imaginaryimpedance/LCR_meter/LCR/LCR.pdf

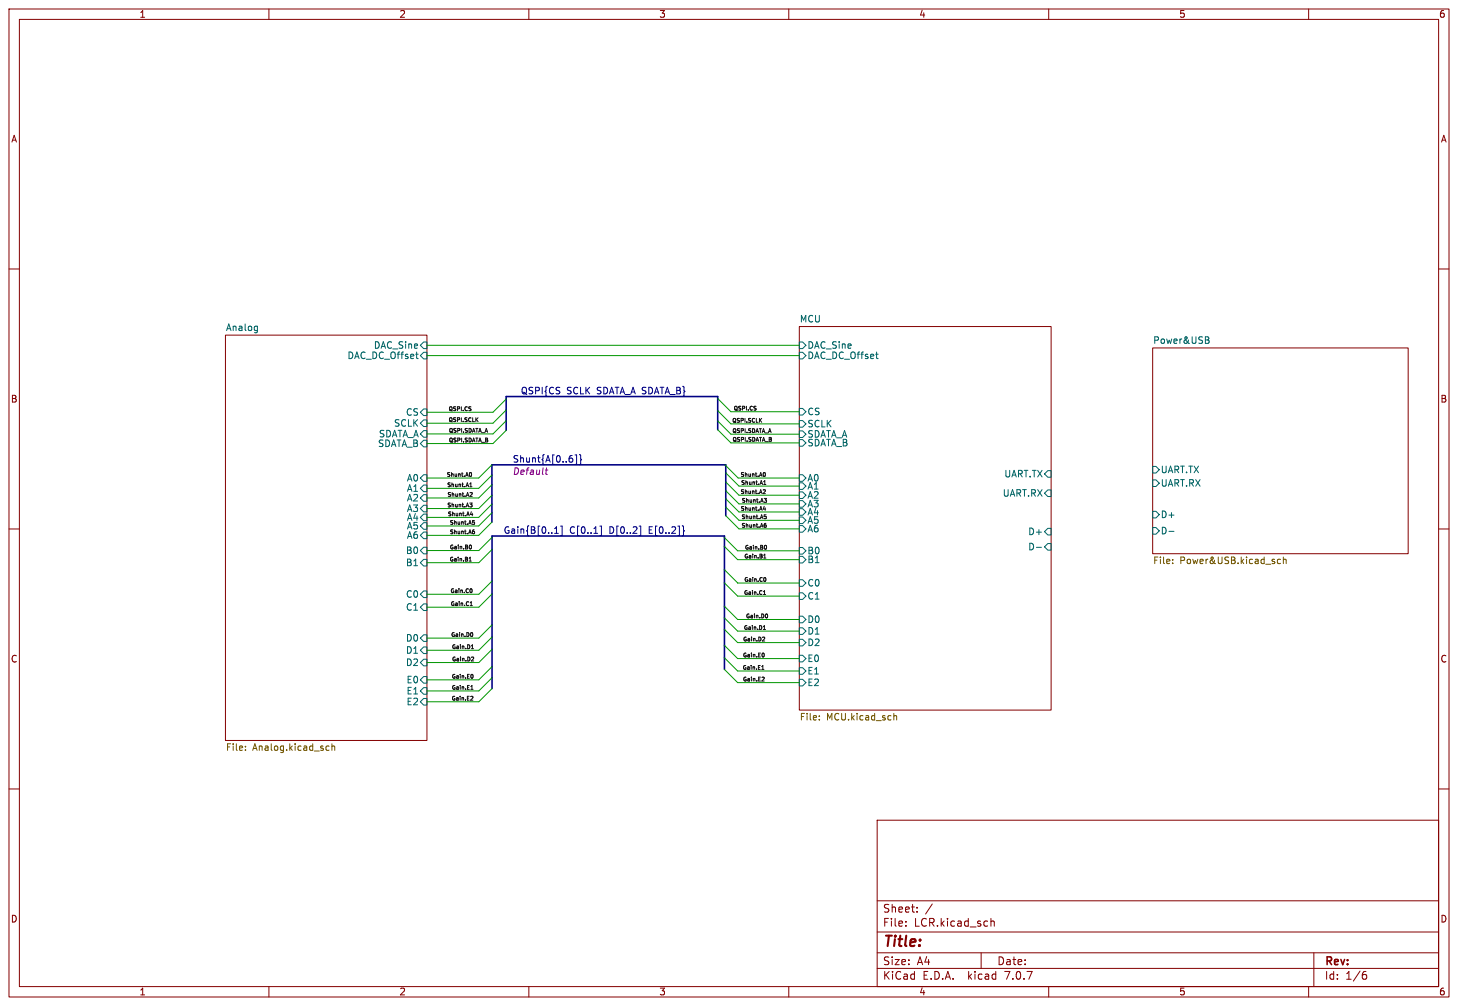
[picture p1: page 1]

Id: 1/6 Title: File: LCR.kicad_sch Sheet: /

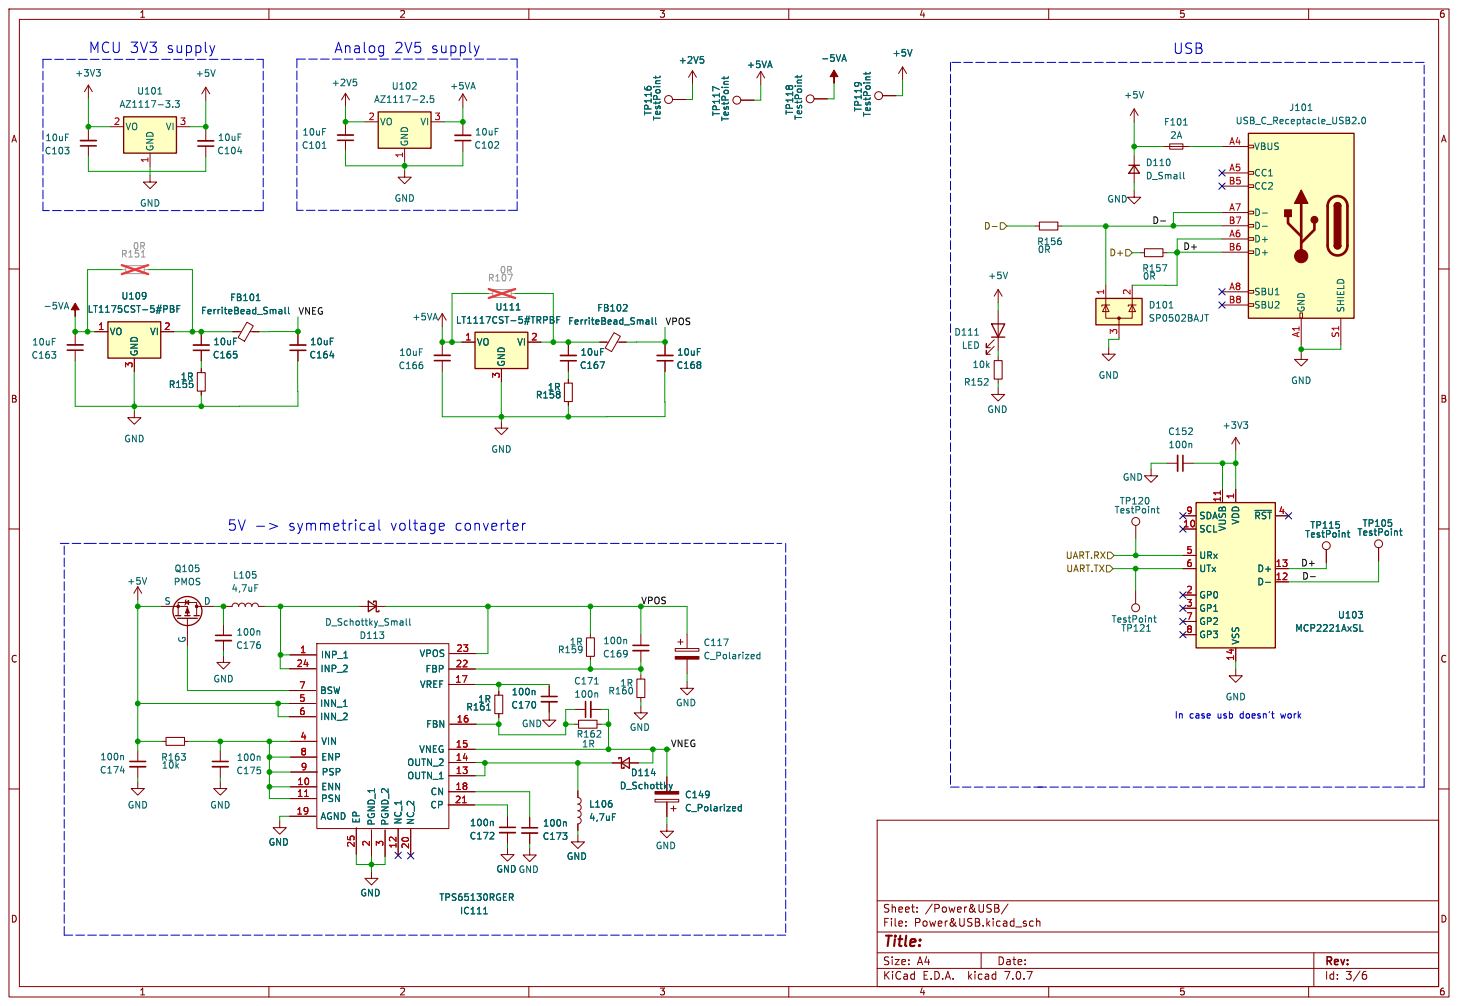
[picture p2: page 2]

In case usb doesn't work USB

1 SCL 10 VUSB 11 D- 12 D+ 13 VSS 14 GP0 2 GP1 3 ~{RST}4 URx 5 UTx 6 GP2 7 GP3 8 SDA 9 U103 MCP2221AxSL TP116 TestPoint

1 SCL 10 VUSB 11 D- 12 D+ 13 VSS 14 GP0 2 GP1 3 ~{RST}4 URx 5 UTx 6 GP2 7 GP3 8 SDA 9 TP115 TestPoint C168

Id: 3/6 Title: File: Power&USB.kicad_sch Sheet: /Power&USB/ GND

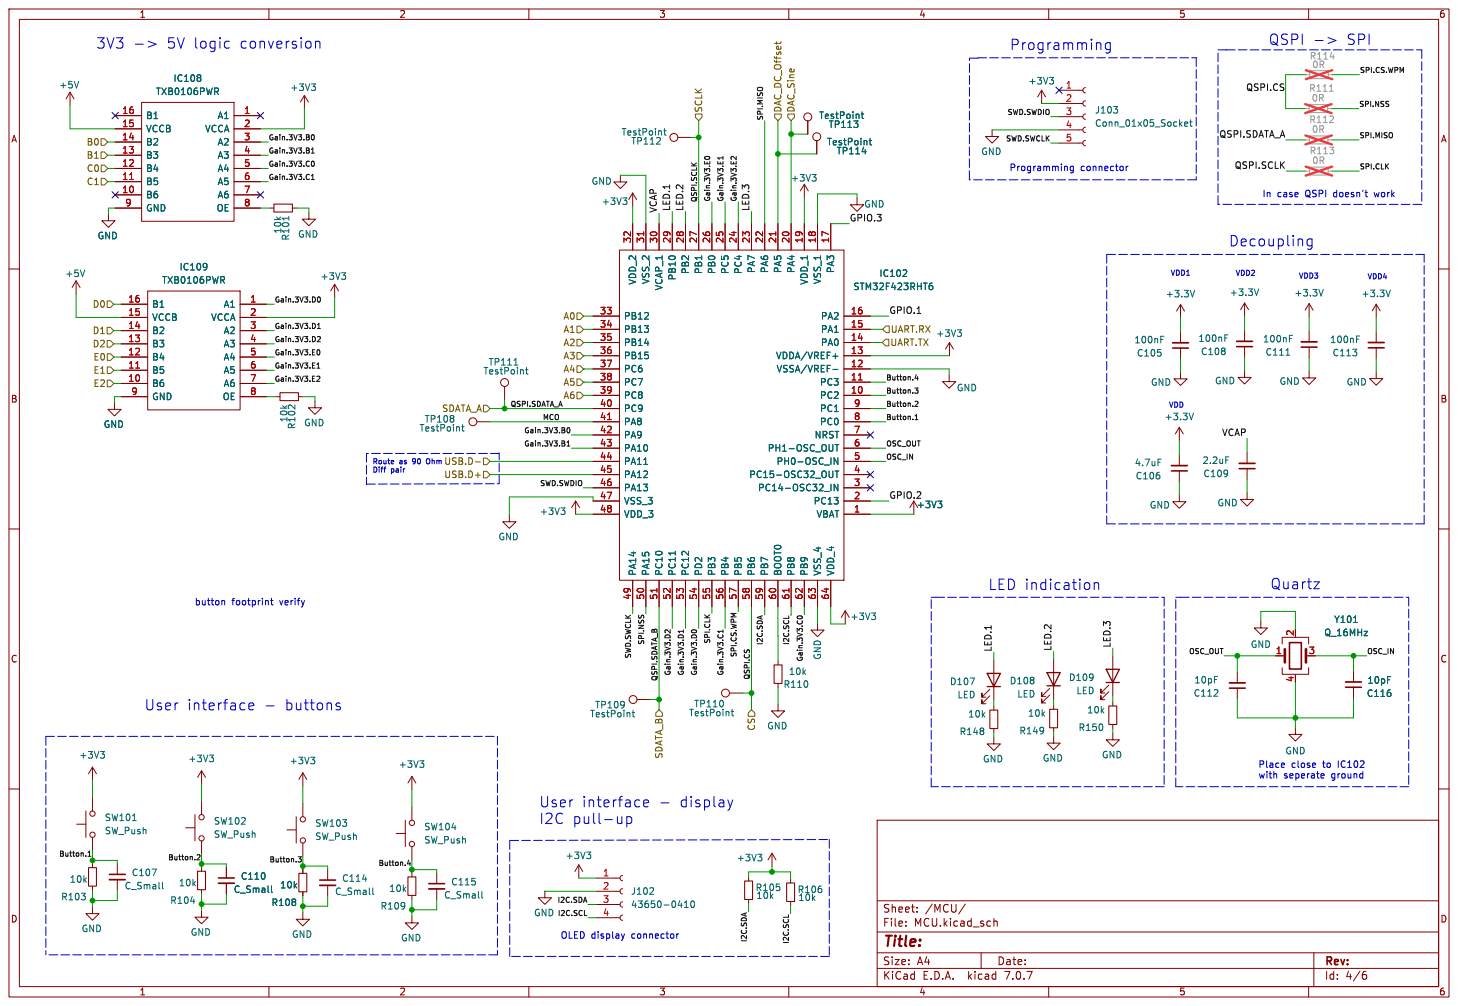
[picture p3: page 3]

In case QSPI doesn't work

Id: 4/6 Title: File: MCU.kicad_sch Sheet: /MCU/ C114 C_Small

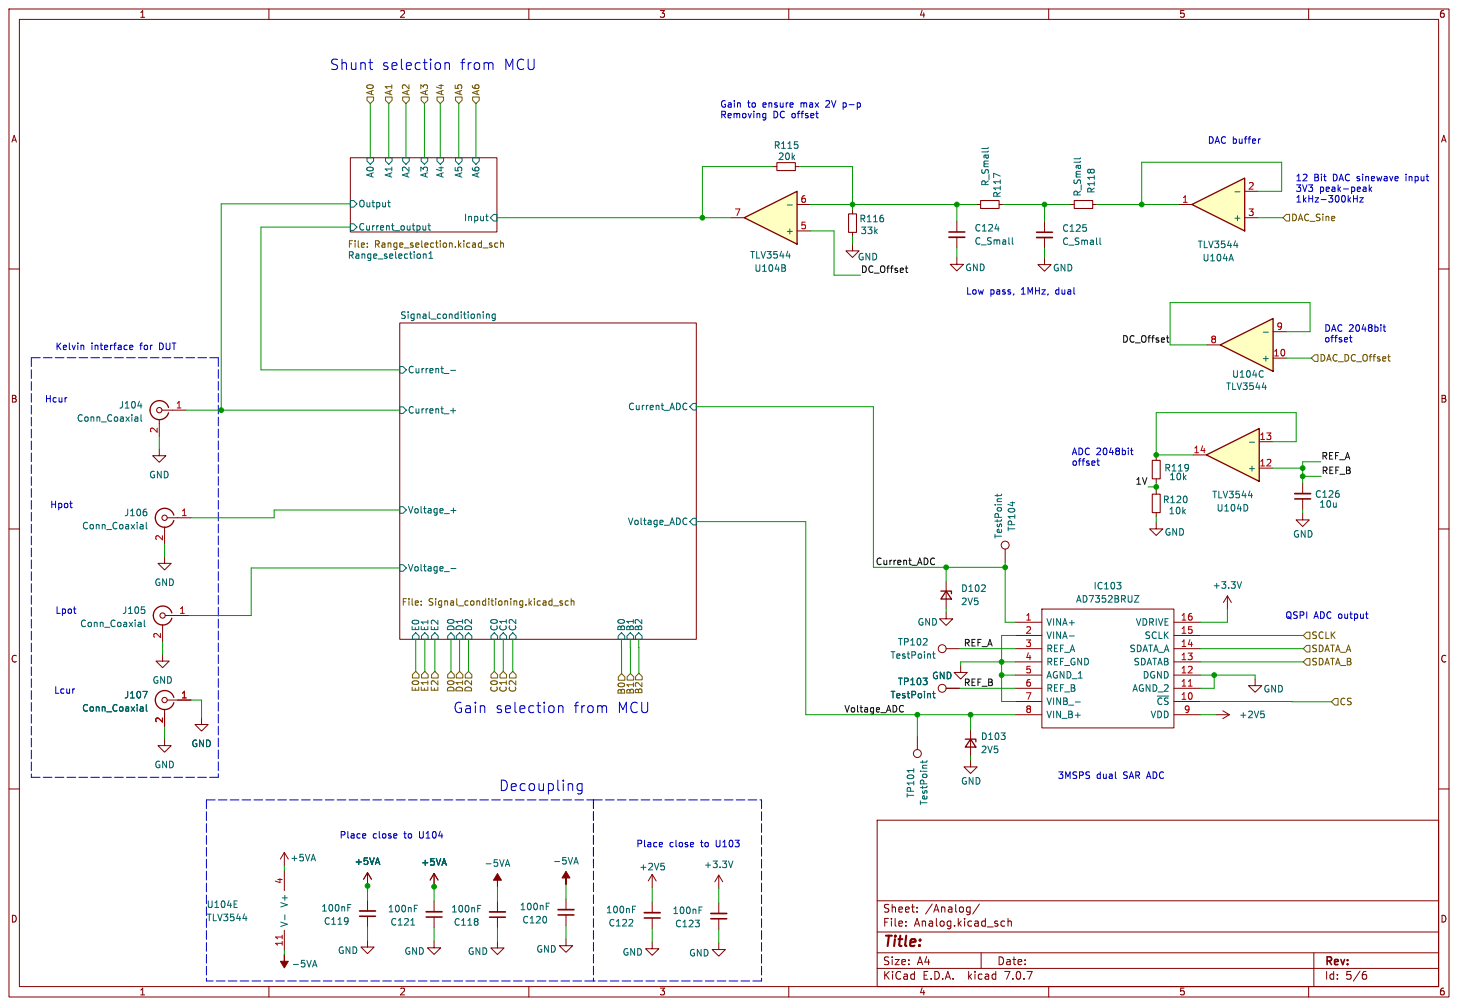
[picture p4: page 4]

Place close to U103 Place close to U104

Id: 5/6 Title: File: Analog.kicad_sch Sheet: /Analog/

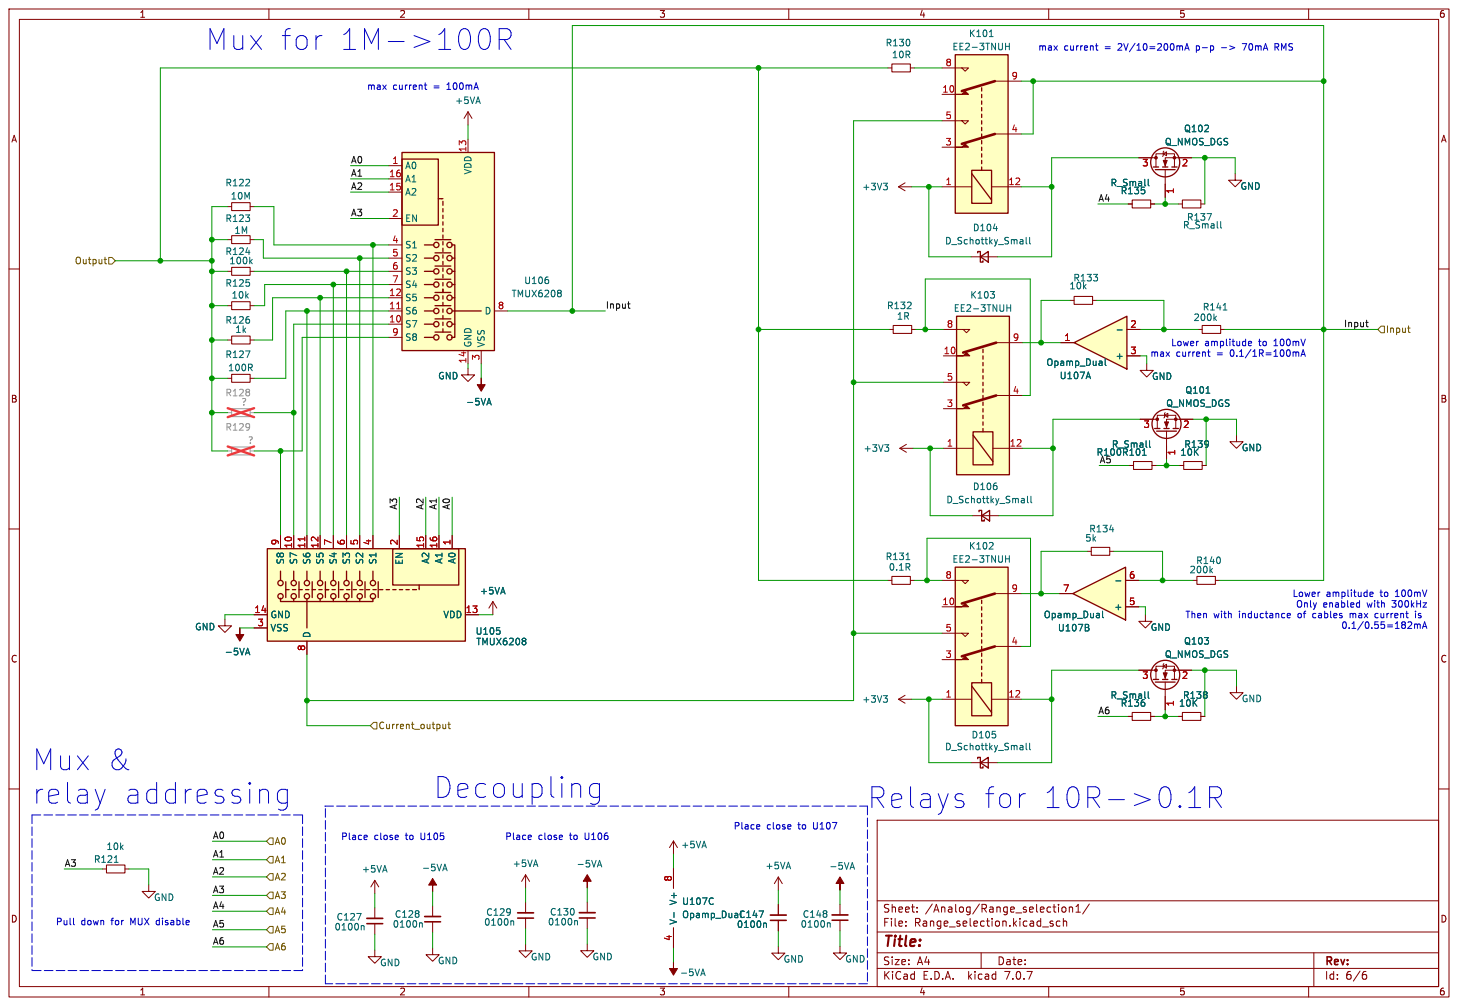
[picture p5: page 5]

Id: 6/6 Title: File: Range_selection.kicad_sch Sheet: /Analog/Range_selection1/

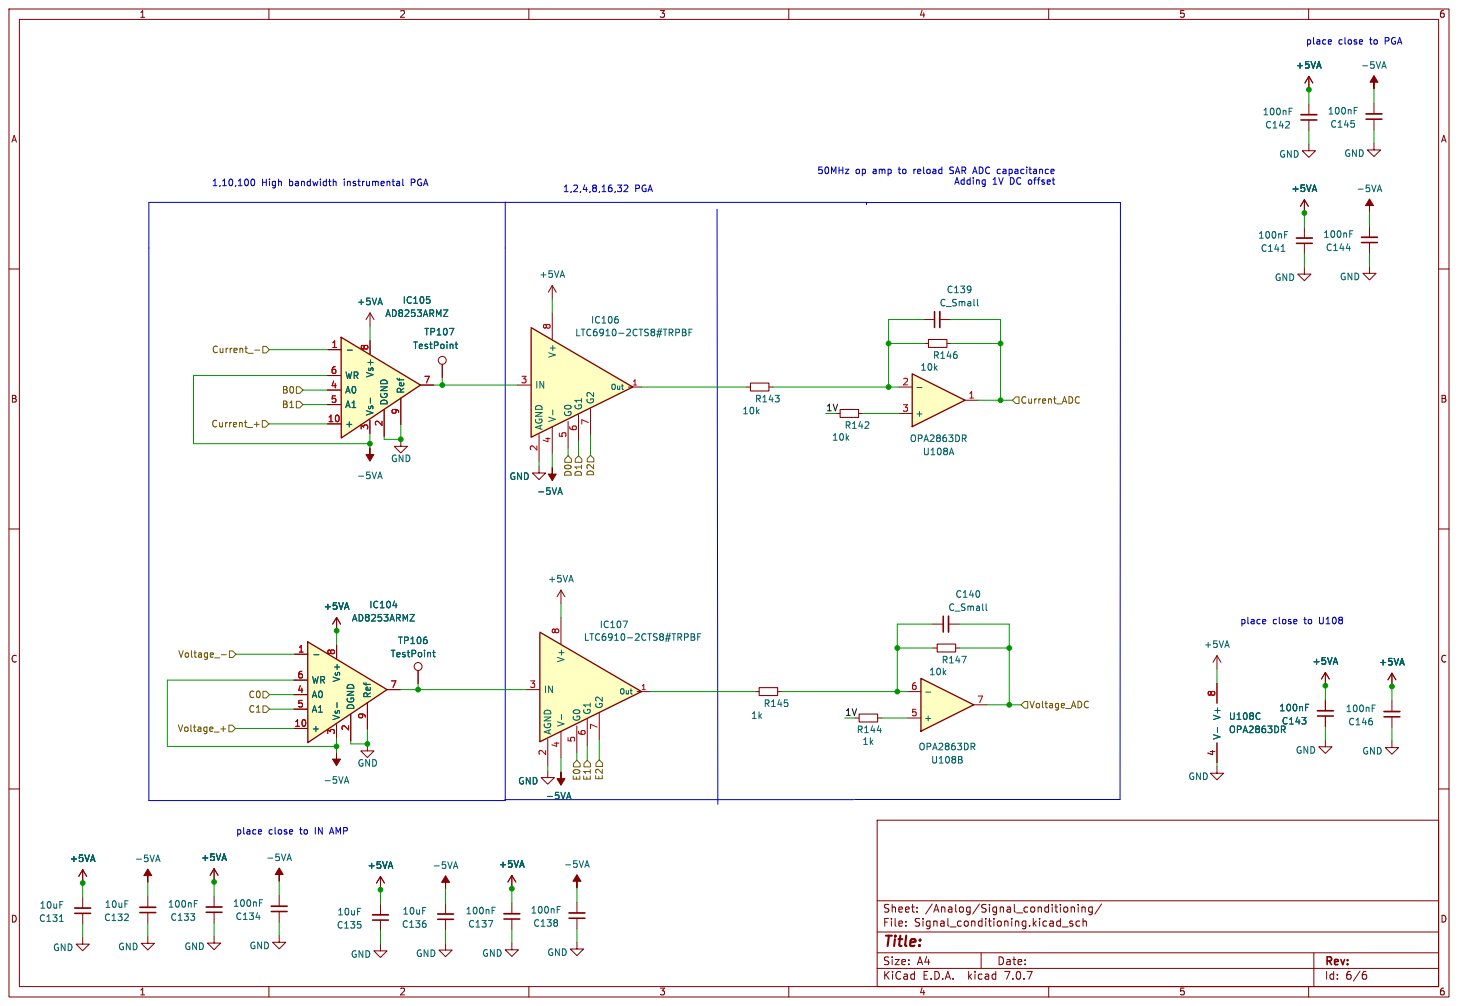
[picture p6: page 6]

place close to PGA

50MHz op amp to reload SAR ADC capacitance

8 Ref 9 IC104 AD8253ARMZ C137
Id: 6/6 Title: File: Signal_conditioning.kicad_sch Sheet: /Analog/Signal_conditioning/ +5VA

place close to IN AMP
