imaginaryimpedance/LCR_meter/LCR/Analog.kicad_sch

## KiCad design LCR/Analog.kicad_sch (2024-11-26)

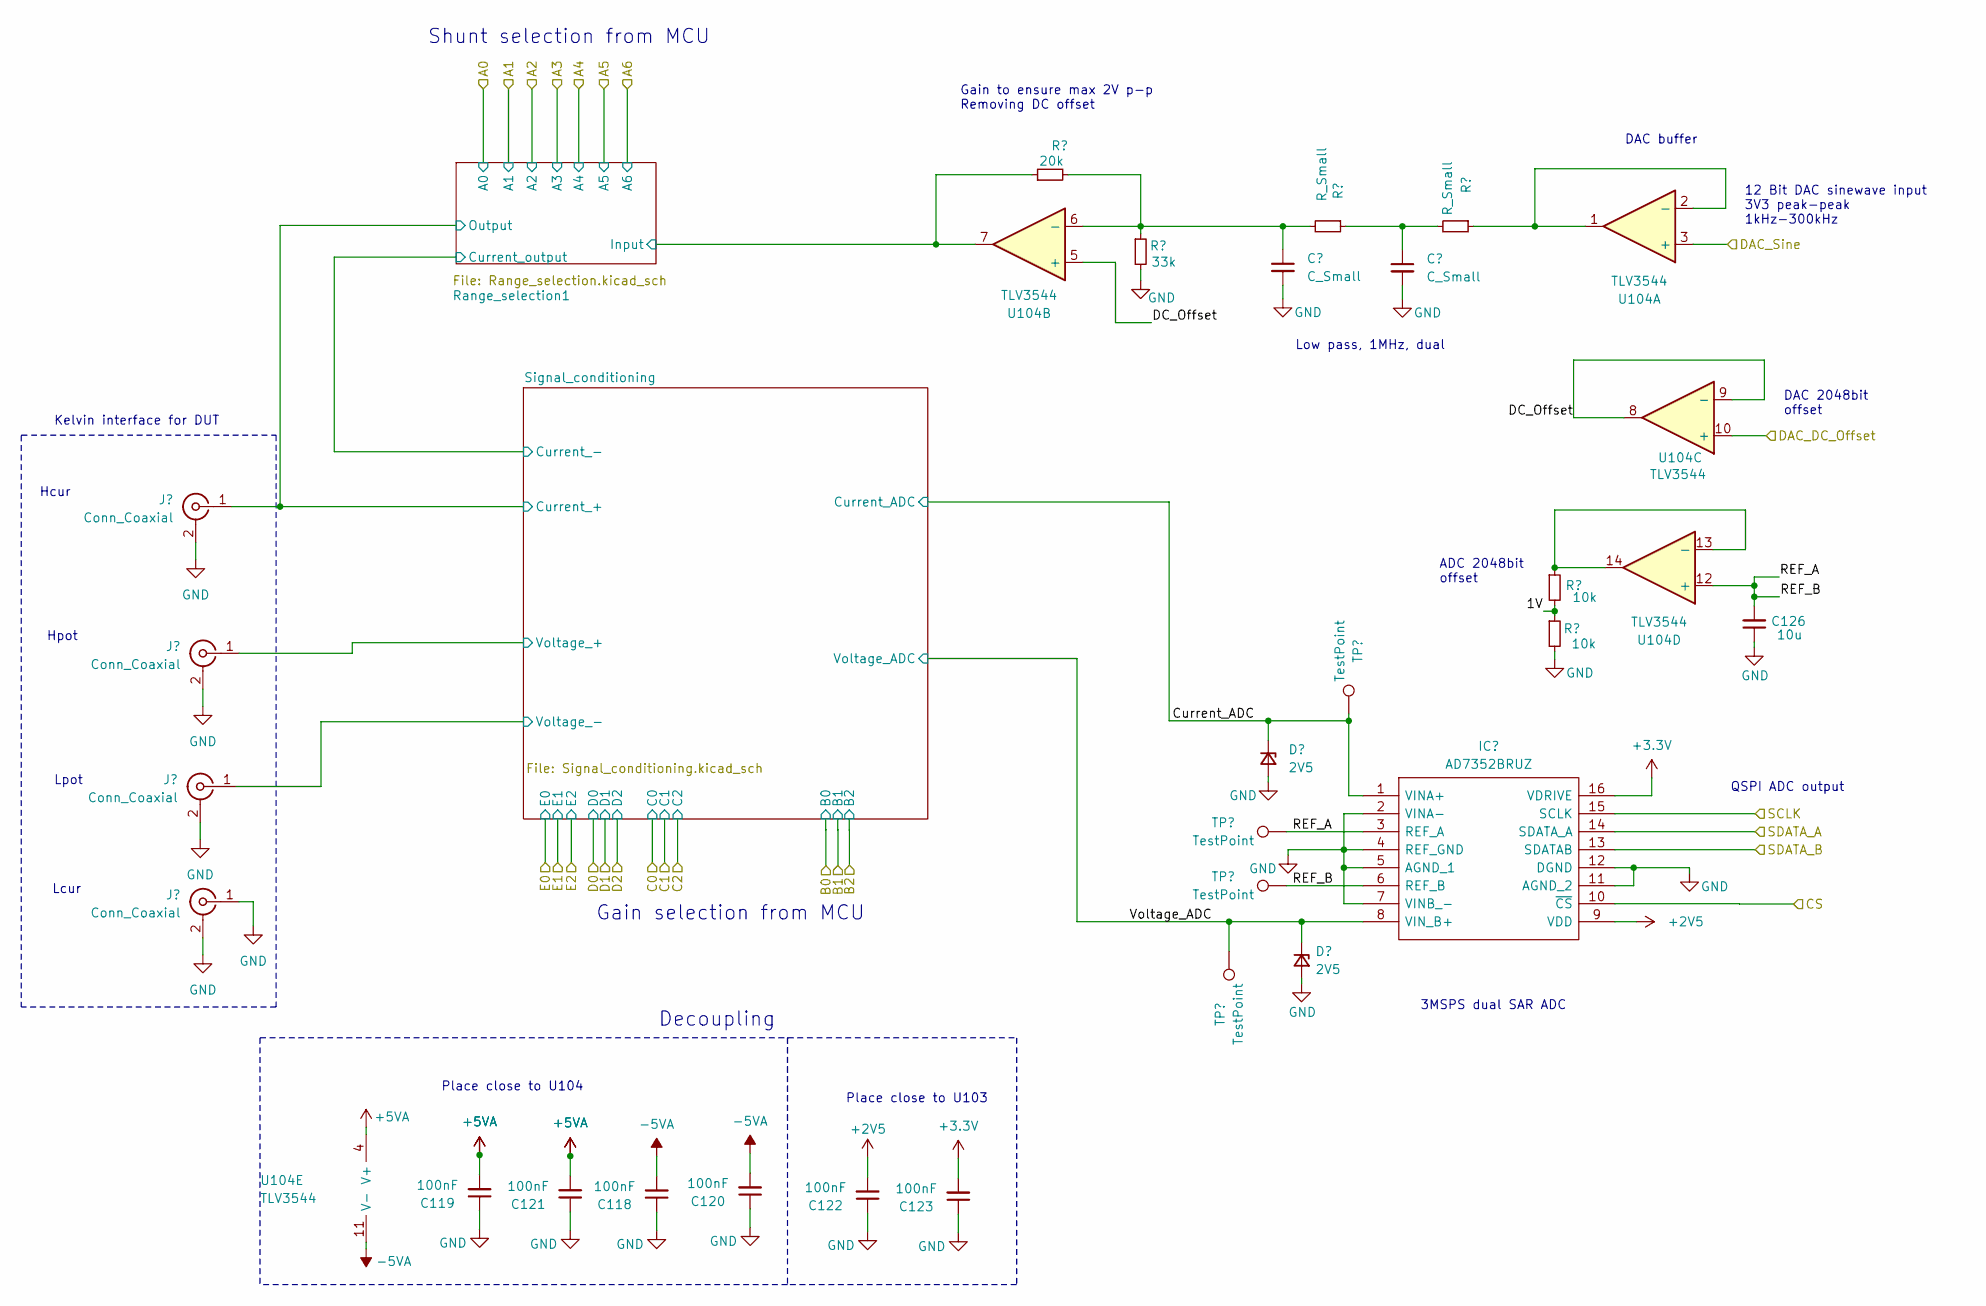
[picture p7: schematic Analog.kicad_sch]

Parts:
C118, C119, C120, C121, C122, C123: 100nF; C_0603_1608Metric
C124, C125: C_Small; C_0603_1608Metric
C126: 10u; C_0603_1608Metric
D102, D103: 2V5; D_SOD-123
IC103: AD7352BRUZ; SOP65P640X120-16N; Manufacturer_Part_Number AD7352BRUZ
J104, J105, J106, J107: Conn_Coaxial; 031543110RFX
R115: 20k; R_0603_1608Metric
R116: 33k; R_0603_1608Metric
R117, R118: R_Small; R_0603_1608Metric
R119, R120: 10k; R_0603_1608Metric
TP101, TP102, TP103, TP104: TestPoint; TestPoint_Pad_D2.0mm
U104: TLV3544; SOIC-14_3.9x8.7mm_P1.27mm

Connections:
1V: R119.2, R120.1
+2V5: C122.2, IC103.9 (VDD)
+3.3V: C123.2, IC103.16 (VDRIVE)
+5VA: C119.2, C121.2, U104.4 (V+)
-5VA: C118.2, C120.2, U104.11 (V-)
CS: IC103.10 (~CS)
Current_+: J104.1 (In)
Current_ADC: D102.1 (K), IC103.1 (VINA+), TP104.1
DAC_DC_Offset: U104.10 (+)
DAC_Sine: U104.3 (+)
DC_Offset: U104.5 (+), U104.8, U104.9 (-)
GND: C118.1, C119.1, C120.1, C121.1, C122.1, C123.1, C124.2, C125.2, C126.1, D102.2 (A), D103.2 (A), IC103.2 (VINA-), IC103.4 (REF_GND), IC103.5 (AGND_1), IC103.7 (VINB_-), IC103.11 (AGND_2), IC103.12 (DGND), J104.2 (Ext), J105.2 (Ext), J106.2 (Ext), J107.1 (In), J107.2 (Ext), R116.2, R120.2
Input: R115.1, U104.7
unnamed: C124.1, R115.2, R116.1, R117.2, U104.6 (-)
unnamed: C125.1, R117.1, R118.2
unnamed: R118.1, U104.1, U104.2 (-)
unnamed: R119.1, U104.13 (-), U104.14
REF_A: C126.2, IC103.3 (REF_A), IC103.6 (REF_B), TP102.1, TP103.1, U104.12 (+)
SCLK: IC103.15 (SCLK)
SDATA_A: IC103.14 (SDATA_A)
SDATA_B: IC103.13 (SDATAB)
Voltage_+: J106.1 (In)
Voltage_-: J105.1 (In)
Voltage_ADC: D103.1 (K), IC103.8 (VIN_B+), TP101.1

Notes on the sheet:
Gain selection from MCU
Shunt selection from MCU
QSPI ADC output
Lcur
Decoupling
Place close to U103
ADC 2048bit offset
DAC 2048bit offset
3MSPS dual SAR ADC
Place close to U104
12 Bit DAC sinewave input 3V3 peak-peak 1kHz-300kHz
Low pass, 1MHz, dual
Lpot
Hcur
Kelvin interface for DUT
Hpot
DAC buffer
Gain to ensure max 2V p-p Removing DC offset
