imaginaryimpedance/LCR_meter/LCR/MCU.kicad_sch

## KiCad design LCR/MCU.kicad_sch (2024-11-26)

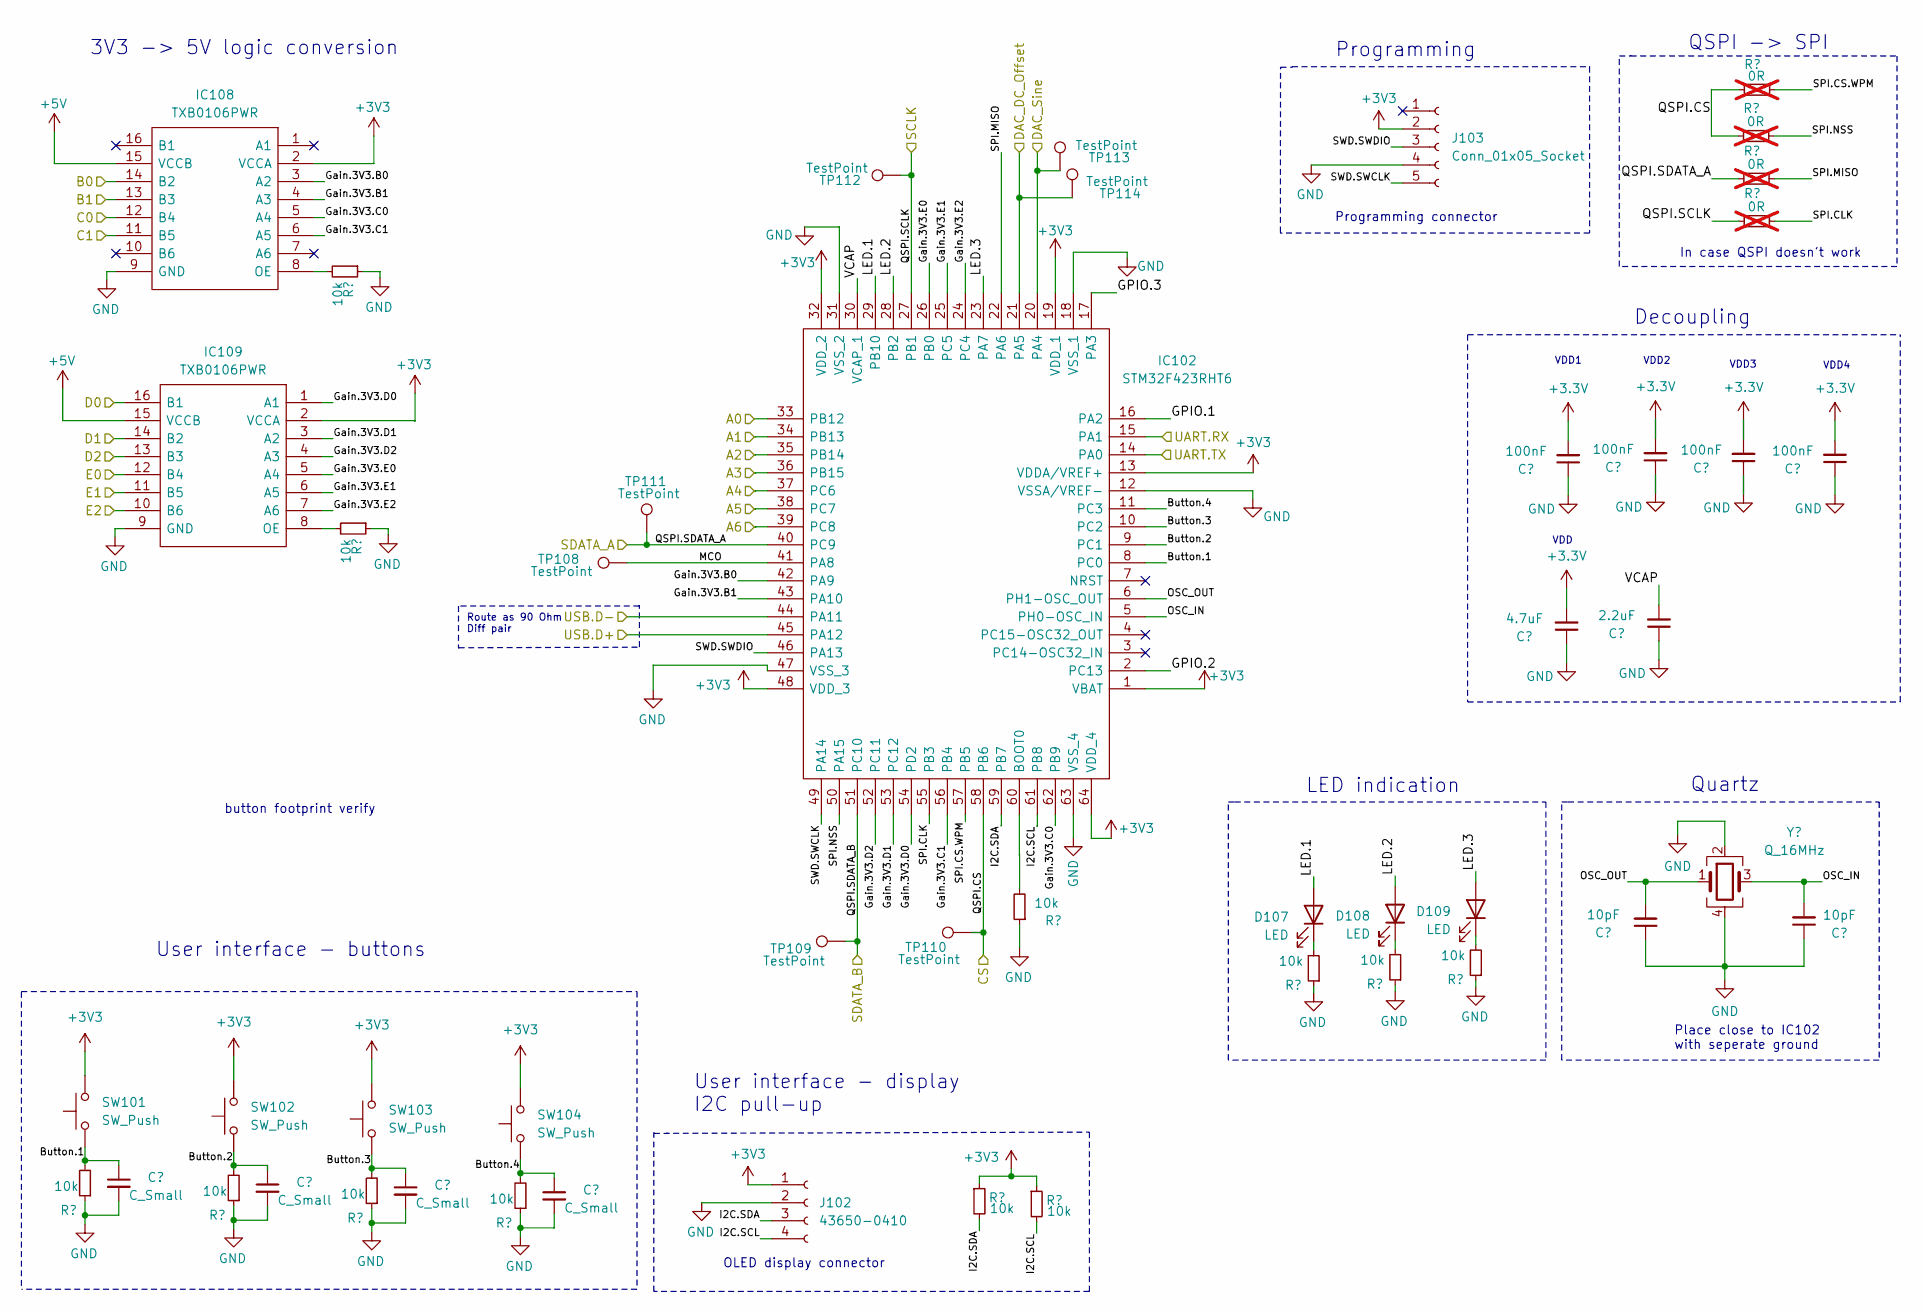
[picture p8: schematic MCU.kicad_sch]

Parts:
C105, C108, C111, C113: 100nF; C_0603_1608Metric
C106: 4.7uF; C_0603_1608Metric
C107, C110, C114, C115: C_Small; C_0603_1608Metric
C109: 2.2uF; C_0603_1608Metric
C112, C116: 10pF; C_0603_1608Metric
D107, D108, D109: LED; LED_1206_3216Metric
IC102: STM32F423RHT6; QFP50P1200X1200X160-64N; Manufacturer_Part_Number STM32F423RHT6; Mouser Part Number 511-STM32F423RHT6
IC108, IC109: TXB0106PWR; SOP65P640X120-16N; Manufacturer_Part_Number TXB0106PWR; Mouser Part Number 595-TXB0106PWR
J102: 43650-0410; 43650-04YY_091011
J103: Conn_01x05_Socket; PinHeader_1x04_P2.54mm_Vertical
R101, R102, R103, R104, R105, R106, R108, R109, R110, R148, R149, R150: 10k; R_0603_1608Metric
R111, R112, R113, R114: 0R; R_0603_1608Metric; not fitted
SW101, SW102, SW103, SW104: SW_Push; SW_Push_1P1T_NO_CK_KSC7xxJ
TP108, TP109, TP110, TP111, TP112, TP113, TP114: TestPoint; TestPoint_Pad_D2.0mm
Y101: Q_16MHz; FH4800014

Connections:
+3.3V: C105.2, C106.2, C108.2, C111.2, C113.2
+3V3: IC102.1 (VBAT), IC102.13 (VDDA/VREF+), IC102.19 (VDD_1), IC102.32 (VDD_2), IC102.48 (VDD_3), IC102.64 (VDD_4), IC108.2 (VCCA), IC109.2 (VCCA), J102.1, J103.2, R105.1, R106.1, SW101.2, SW102.2, SW103.2, SW104.2
+5V: IC108.15 (VCCB), IC109.15 (VCCB)
A0: IC102.33 (PB12)
A1: IC102.34 (PB13)
A2: IC102.35 (PB14)
A3: IC102.36 (PB15)
A4: IC102.37 (PC6)
A5: IC102.38 (PC7)
A6: IC102.39 (PC8)
B0: IC108.14 (B2)
B1: IC108.13 (B3)
Button.1: C107.1, IC102.8 (PC0), R103.2, SW101.1
Button.2: C110.1, IC102.9 (PC1), R104.2, SW102.1
Button.3: C114.1, IC102.10 (PC2), R108.2, SW103.1
Button.4: C115.1, IC102.11 (PC3), R109.2, SW104.1
C0: IC108.12 (B4)
C1: IC108.11 (B5)
CS: IC102.58 (PB6), R111.2, R114.2, TP110.1
D0: IC109.16 (B1)
D1: IC109.14 (B2)
D2: IC109.13 (B3)
DAC_DC_Offset: IC102.21 (PA5), TP114.1
DAC_Sine: IC102.20 (PA4), TP113.1
E0: IC109.12 (B4)
E1: IC109.11 (B5)
E2: IC109.10 (B6)
GND: C105.1, C106.1, C107.2, C108.1, C109.1, C110.2, C111.1, C112.1, C113.1, C114.2, C115.2, C116.1, IC102.12 (VSSA/VREF-), IC102.18 (VSS_1), IC102.31 (VSS_2), IC102.47 (VSS_3), IC102.63 (VSS_4), IC108.9 (GND), IC109.9 (GND), J102.2, J103.4, R101.1, R102.1, R103.1, R104.1, R108.1, R109.1, R110.1, R148.1, R149.1, R150.1, Y101.2, Y101.4
GPIO.1: IC102.16 (PA2)
GPIO.2: IC102.2 (PC13)
GPIO.3: IC102.17 (PA3)
Gain.3V3.B0: IC102.42 (PA9), IC108.3 (A2)
Gain.3V3.B1: IC102.43 (PA10), IC108.4 (A3)
Gain.3V3.C0: IC102.62 (PB9), IC108.5 (A4)
Gain.3V3.C1: IC102.56 (PB4), IC108.6 (A5)
Gain.3V3.D0: IC102.54 (PD2), IC109.1 (A1)
Gain.3V3.D1: IC102.53 (PC12), IC109.3 (A2)
Gain.3V3.D2: IC102.52 (PC11), IC109.4 (A3)
Gain.3V3.E0: IC102.26 (PB0), IC109.5 (A4)
Gain.3V3.E1: IC102.25 (PC5), IC109.6 (A5)
Gain.3V3.E2: IC102.24 (PC4), IC109.7 (A6)
I2C.SCL: IC102.61 (PB8), J102.4, R106.2
I2C.SDA: IC102.59 (PB7), J102.3, R105.2
LED.1: D107.2 (A), IC102.29 (PB10)
LED.2: D108.2 (A), IC102.28 (PB2)
LED.3: D109.2 (A), IC102.23 (PA7)
MCO: IC102.41 (PA8), TP108.1
unnamed: D107.1 (K), R148.2
unnamed: D108.1 (K), R149.2
unnamed: D109.1 (K), R150.2
unnamed: IC102.60 (BOOT0), R110.2
unnamed: IC108.8 (OE), R101.2
unnamed: IC109.8 (OE), R102.2
OSC_IN: C116.2, IC102.5 (PH0-OSC_IN), Y101.3
OSC_OUT: C112.2, IC102.6 (PH1-OSC_OUT), Y101.1
QSPI.SCLK: IC102.27 (PB1), R113.2, TP112.1
QSPI.SDATA_A: IC102.40 (PC9), R112.2, TP111.1
QSPI.SDATA_B: IC102.51 (PC10), TP109.1
SPI.CLK: IC102.55 (PB3), R113.1
SPI.CS.WPM: IC102.57 (PB5), R114.1
SPI.MISO: IC102.22 (PA6), R112.1
SPI.NSS: IC102.50 (PA15), R111.1
SWD.SWCLK: IC102.49 (PA14), J103.5
SWD.SWDIO: IC102.46 (PA13), J103.3
UART.RX: IC102.15 (PA1)
UART.TX: IC102.14 (PA0)
USB.D+: IC102.45 (PA12)
USB.D-: IC102.44 (PA11)
VCAP: C109.2, IC102.30 (VCAP_1)

Notes on the sheet:
3V3 -> 5V logic conversion
VDD
VDD1
Route as 90 Ohm Diff pair
QSPI -> SPI
Quartz
In case QSPI doesn't work
VDD3
VDD4
User interface - display I2C pull-up
button footprint verify
User interface - buttons
LED indication
VDD2
Place close to IC102 with seperate ground
Programming connector
Programming
OLED display connector
Decoupling
