imaginaryimpedance/LCR_meter/LCR/Power&USB.kicad_sch

## KiCad design LCR/Power&USB.kicad_sch (2024-11-26)

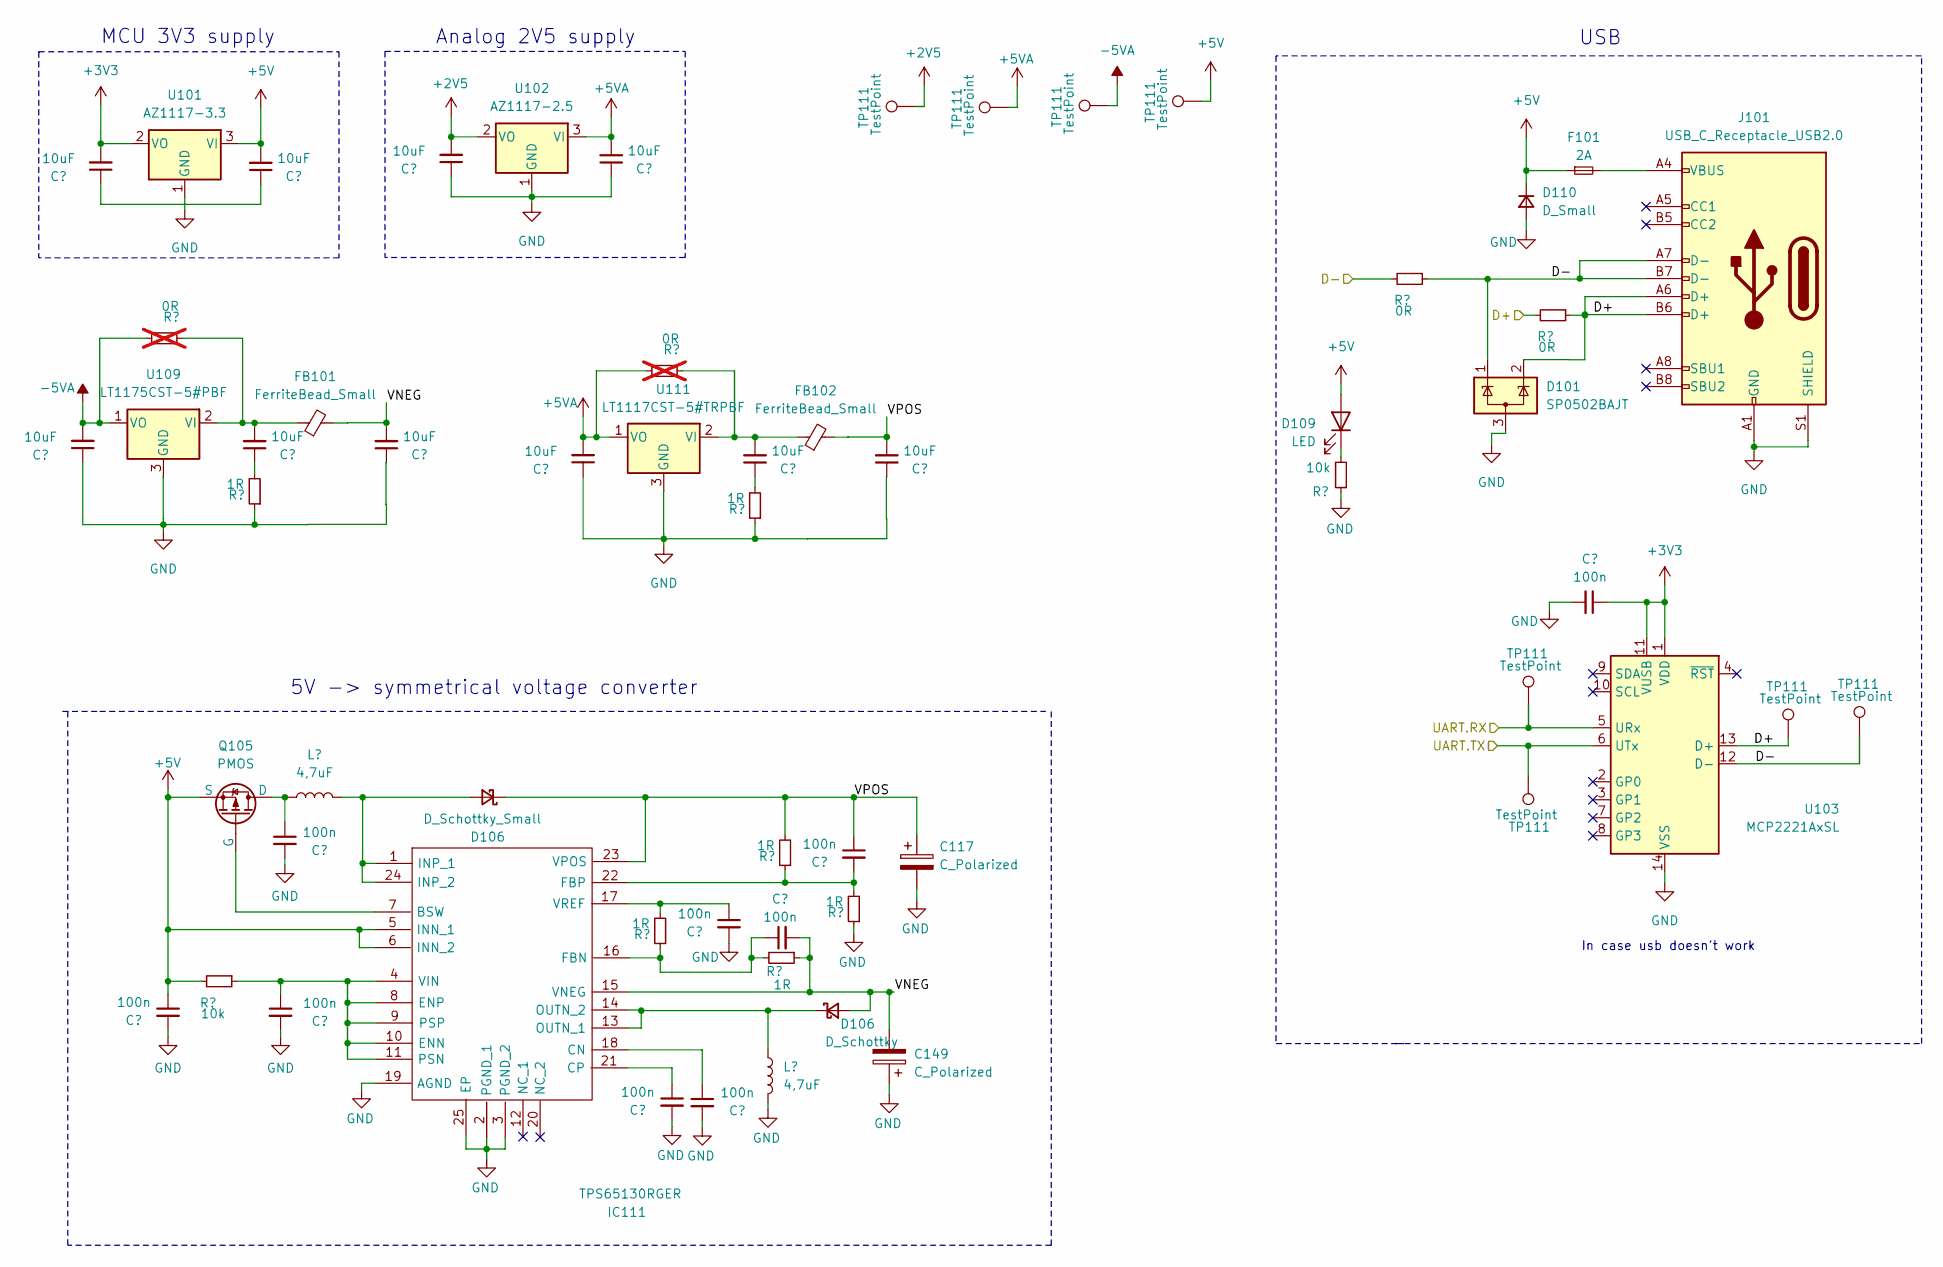
[picture p9: schematic Power&USB.kicad_sch]

Parts:
C105: 100n; C_0603_1608Metric
C117, C149: C_Polarized; CP_Elec_5x5.3
D101: SP0502BAJT; SOT-23-3
D106: D_Schottky; D_SOD-123
D109: LED; LED_1206_3216Metric
D110: D_Small; D_SOD-123
F101: 2A; R_1206_3216Metric
FB101, FB102: FerriteBead_Small; R_1206_3216Metric
IC111: TPS65130RGER; QFN50P400X400X100-25N-D; Manufacturer_Part_Number TPS65130RGER; Mouser Part Number 595-TPS65130RGER
J101: USB_C_Receptacle_USB2.0; USB_C_Receptacle_GCT_USB4115-03-C
L105, L106: 4,7uF; 744031004
Q105: PMOS; SOT-23-3
R105: 0R; R_0603_1608Metric; not fitted
R150: 10k; R_0603_1608Metric
TP111: TestPoint; TestPoint_Pad_D2.0mm
U101: AZ1117-3.3; SOT-89-3
U102: AZ1117-2.5; SOT-89-3
U103: MCP2221AxSL; SOIC-14_3.9x8.7mm_P1.27mm
U109: LT1175CST-5#PBF; SOT-223-3_TabPin2
U111: LT1117CST-5#TRPBF; SOT-223-3_TabPin2

Connections:
+2V5: C105.2, TP111.1, U102.2 (VO)
+3V3: C105.1, C105.2, U101.2 (VO), U103.1 (VDD), U103.11 (VUSB)
+5V: C105.1, C105.2, D109.2 (A), D110.1 (K), F101.1, IC111.5 (INN_1), IC111.6 (INN_2), Q105.2 (S), R105.2, TP111.1, U101.3 (VI)
+5VA: C105.2, R105.1, TP111.1, U102.3 (VI), U111.1 (VO)
-5VA: C105.2, R105.1, TP111.1, U109.1 (VO)
D+: D101.2 (K), J101.A6 (D+), J101.B6 (D+), R105.1, R105.2, TP111.1, U103.13 (D+)
D-: D101.1 (K), J101.A7 (D-), J101.B7 (D-), R105.1, R105.2, TP111.1, U103.12 (D-)
GND: C105.1, C105.2, C117.2, C149.1, D101.3 (A), D110.2 (A), IC111.2 (PGND_1), IC111.3 (PGND_2), IC111.19 (AGND), IC111.25 (EP), J101.A1 (GND), J101.A12 (GND), J101.B1 (GND), J101.B12 (GND), J101.S1 (SHIELD), L106.2, R105.1, R150.1, U101.1 (GND), U102.1 (GND), U103.14 (VSS), U109.3 (GND), U111.3 (GND)
unnamed: C105.1, IC111.4 (VIN), IC111.8 (ENP), IC111.9 (PSP), IC111.10 (ENN), IC111.11 (PSN), IC111.16 (FBN), IC111.17 (VREF), IC111.18 (CN), IC111.21 (CP), L105.1, Q105.3 (D), R105.1, R105.2
unnamed: C105.2, FB101.1, FB102.1, IC111.22 (FBP), R105.1, R105.2, U109.2 (VI), U111.2 (VI)
unnamed: D106.1 (K), IC111.13 (OUTN_1), IC111.14 (OUTN_2), L106.1
unnamed: D106.2 (A), IC111.1 (INP_1), IC111.24 (INP_2), L105.2
unnamed: D109.1 (K), R150.2
unnamed: F101.2, J101.A4 (VBUS), J101.A9 (VBUS), J101.B4 (VBUS), J101.B9 (VBUS)
unnamed: IC111.7 (BSW), Q105.1 (G)
UART.RX: TP111.1, U103.5 (URx)
UART.TX: TP111.1, U103.6 (UTx)
VNEG: C105.2, C149.2, D106.2 (A), FB101.2, IC111.15 (VNEG), R105.1
VPOS: C105.1, C105.2, C117.1, D106.1 (K), FB102.2, IC111.23 (VPOS), R105.2

Notes on the sheet:
In case usb doesn't work
USB
MCU 3V3 supply
5V -> symmetrical voltage converter
Analog 2V5 supply
