imaginaryimpedance/LCR_meter/LCR/Range_selection.kicad_sch

## KiCad design LCR/Range_selection.kicad_sch (2024-11-26)

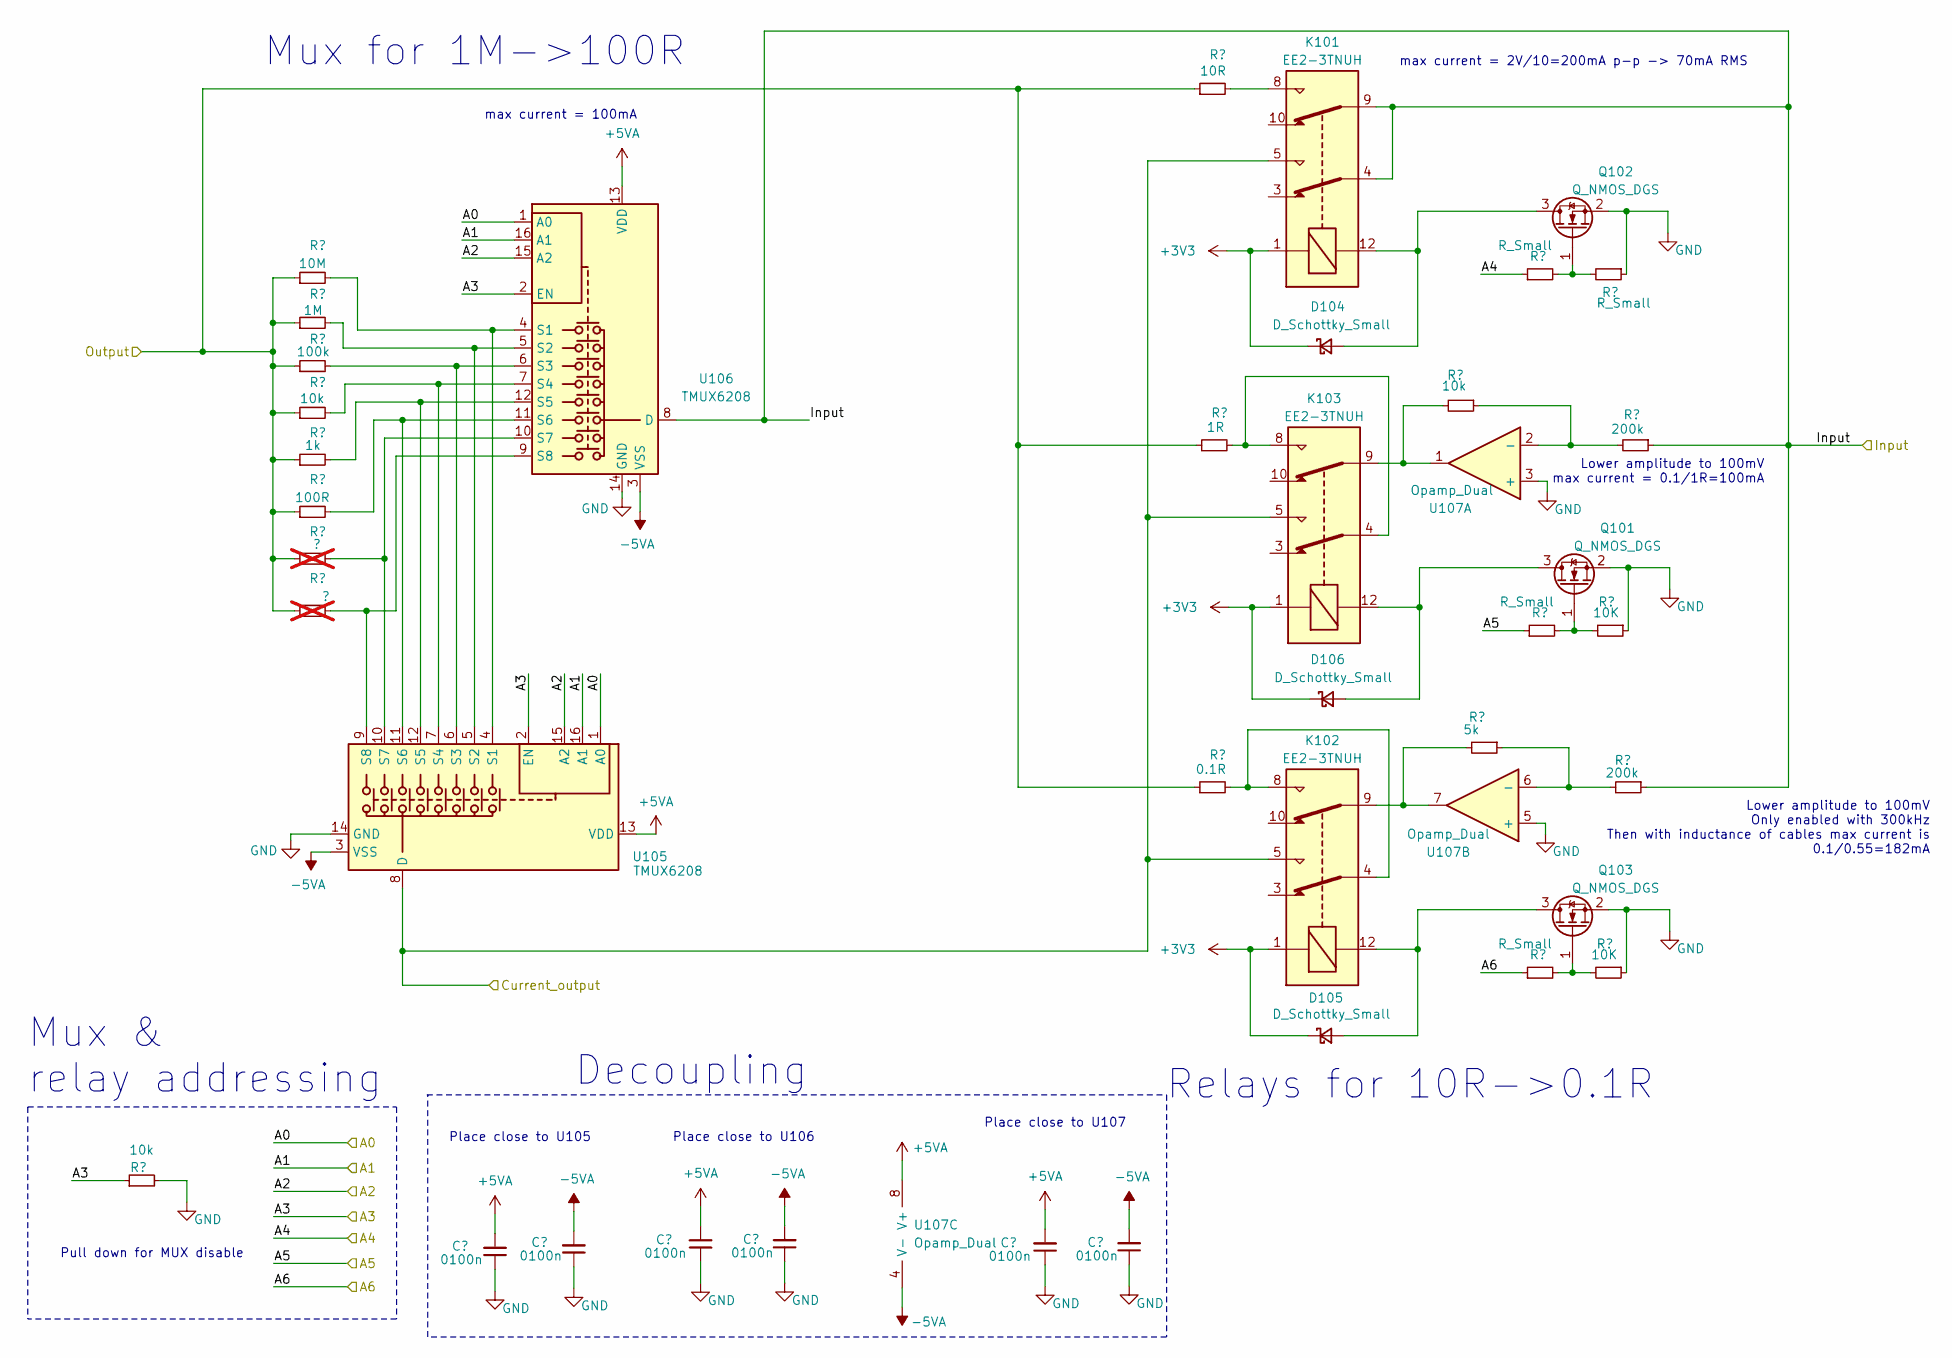
[picture p10: schematic Range_selection.kicad_sch]

Parts:
C127, C128, C129, C130, C147, C148: 0100n; C_0603_1608Metric
D104, D105, D106: D_Schottky_Small; D_SOD-123
K101, K102, K103: EE2-3TNUH; EE23NUH
Q101, Q102, Q103: Q_NMOS_DGS; SOT-23-3
R100R101, R135, R136, R137: R_Small; R_0603_1608Metric
R121, R125, R133: 10k; R_0603_1608Metric
R122: 10M; R_0603_1608Metric
R123: 1M; R_0603_1608Metric
R124: 100k; R_0603_1608Metric
R126: 1k; R_0603_1608Metric
R127: 100R; R_0603_1608Metric
R128, R129: ?; R_0603_1608Metric; not fitted
R130: 10R; R_0603_1608Metric
R131: 0.1R; R_0603_1608Metric
R132: 1R; R_0603_1608Metric
R134: 5k; R_0603_1608Metric
R138, R139: 10K; R_0603_1608Metric
R140, R141: 200k; R_0603_1608Metric
U105, U106: TMUX6208; TSSOP-16_4.4x5mm_P0.65mm
U107: Opamp_Dual; SOIC127P600X175-8N

Connections:
+3V3: D104.1 (K), D105.1 (K), D106.1 (K), K101.1, K102.1, K103.1
+5VA: C127.2, C129.2, C147.2, U105.13 (VDD), U106.13 (VDD), U107.8 (V+)
-5VA: C128.2, C130.2, C148.2, U105.3 (VSS), U106.3 (VSS), U107.4 (V-)
A0: U105.1 (A0), U106.1 (A0)
A1: U105.16 (A1), U106.16 (A1)
A2: U105.15 (A2), U106.15 (A2)
A3: R121.1, U105.2 (EN), U106.2 (EN)
A4: R135.1
A5: R100R101.1
A6: R136.1
Current_output: K101.5, K102.5, K103.5, U105.8 (D)
GND: C127.1, C128.1, C129.1, C130.1, C147.1, C148.1, Q101.2 (S), Q102.2 (S), Q103.2 (S), R121.2, R137.1, R138.1, R139.1, U105.14 (GND), U106.14 (GND), U107.3 (+), U107.5 (+)
Input: K101.4, K101.9, R140.1, R141.1, U106.8 (D)
unnamed: D104.2 (A), K101.12, Q102.3 (D)
unnamed: D105.2 (A), K102.12, Q103.3 (D)
unnamed: D106.2 (A), K103.12, Q101.3 (D)
unnamed: K101.8, R130.2
unnamed: K102.4, K102.8, R131.2
unnamed: K102.9, R134.2, U107.7
unnamed: K103.4, K103.8, R132.2
unnamed: K103.9, R133.2, U107.1
unnamed: Q101.1 (G), R100R101.2, R139.2
unnamed: Q102.1 (G), R135.2, R137.2
unnamed: Q103.1 (G), R136.2, R138.2
unnamed: R122.2, U105.4 (S1), U106.4 (S1)
unnamed: R123.2, U105.5 (S2), U106.5 (S2)
unnamed: R124.2, U105.6 (S3), U106.6 (S3)
unnamed: R125.2, U105.7 (S4), U106.7 (S4)
unnamed: R126.2, U105.12 (S5), U106.12 (S5)
unnamed: R127.2, U105.11 (S6), U106.11 (S6)
unnamed: R128.2, U105.10 (S7), U106.10 (S7)
unnamed: R129.2, U105.9 (S8), U106.9 (S8)
unnamed: R133.1, R141.2, U107.2 (-)
unnamed: R134.1, R140.2, U107.6 (-)
Output: R122.1, R123.1, R124.1, R125.1, R126.1, R127.1, R128.1, R129.1, R130.1, R131.1, R132.1

Notes on the sheet:
Mux for 1M->100R
Place close to U105
Pull down for MUX disable
Decoupling
Lower amplitude to 100mV Only enabled with 300kHz Then with inductance of cables max current is 0.1/0.55=182mA
max current = 100mA
Lower amplitude to 100mV max current = 0.1/1R=100mA
max current = 2V/10=200mA p-p -> 70mA RMS
Place close to U106
Place close to U107
Relays for 10R->0.1R
Mux & relay addressing
