imaginaryimpedance/LCR_meter/LCR/Signal_conditioning.kicad_sch

## KiCad design LCR/Signal_conditioning.kicad_sch (2024-11-26)

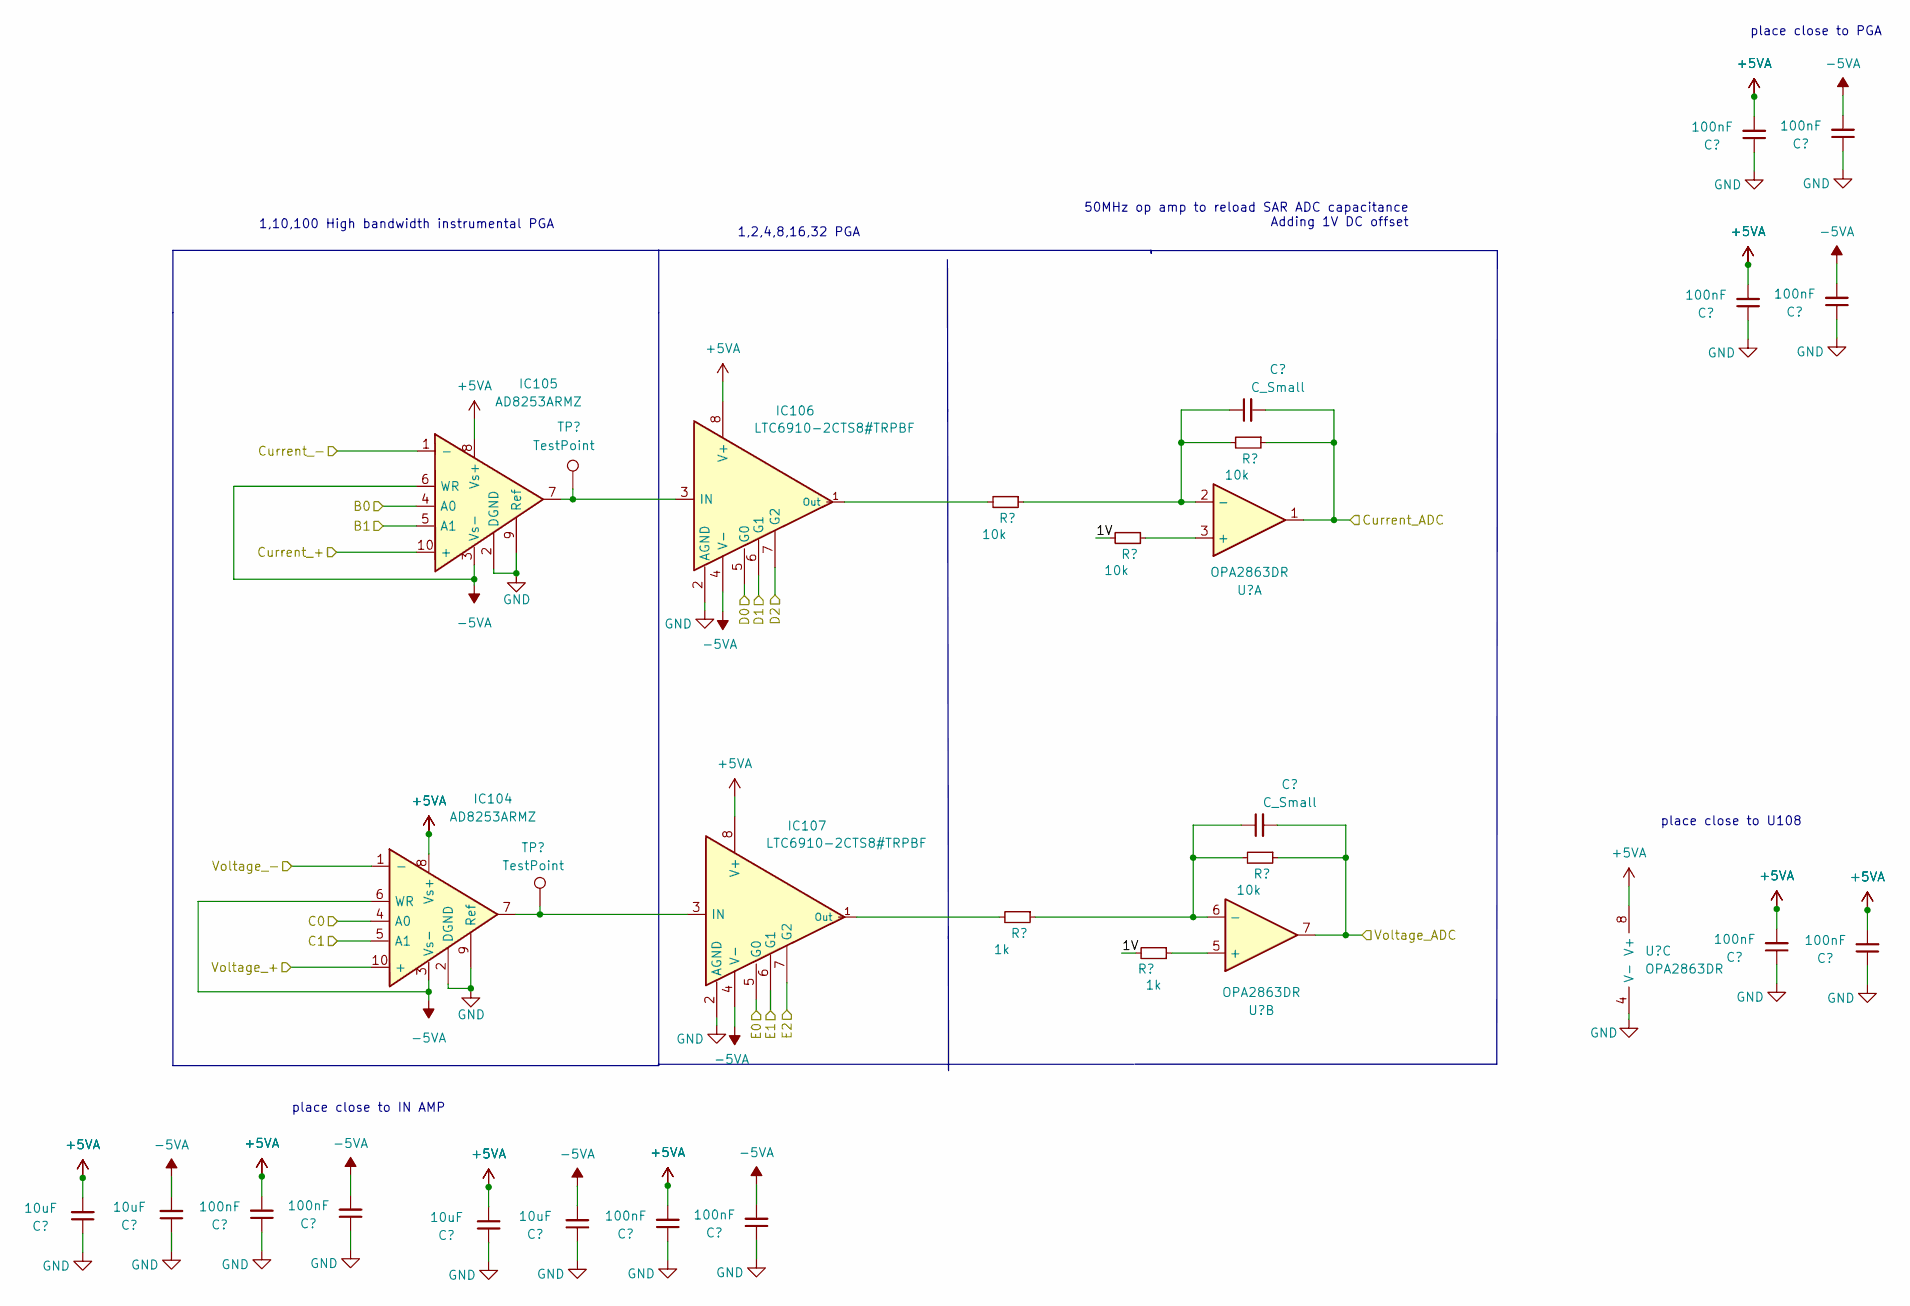
[picture p11: schematic Signal_conditioning.kicad_sch]

Parts:
C131, C132, C135, C136: 10uF; C_0603_1608Metric
C133, C134, C137, C138, C141, C142, C143, C144, C145, C146: 100nF; C_0603_1608Metric
C139, C140: C_Small; C_0603_1608Metric
IC104, IC105: AD8253ARMZ; SOP50P490X110-10N; Manufacturer_Part_Number AD8253ARMZ; Mouser Part Number 584-AD8253ARMZ
IC106, IC107: LTC6910-2CTS8#TRPBF; SOT65P280X100-8N; Manufacturer_Part_Number LTC6910-2CTS8#TRPBF; Mouser Part Number 584-C6910-2CTS8TRPBF
R142, R143, R146, R147: 10k; R_0603_1608Metric
R144, R145: 1k; R_0603_1608Metric
TP106, TP107: TestPoint; TestPoint_Pad_D2.0mm
U108: OPA2863DR; SOIC127P600X175-8N

Connections:
1V: R142.2, R144.2
+5VA: C131.2, C133.2, C135.2, C137.2, C141.2, C142.2, C143.2, C146.2, IC104.8 (Vs+), IC105.8 (Vs+), IC106.8 (V+), IC107.8 (V+), U108.8 (V+)
-5VA: C132.2, C134.2, C136.2, C138.2, C144.2, C145.2, IC104.3 (Vs-), IC104.6 (WR), IC105.3 (Vs-), IC105.6 (WR), IC106.4 (V-), IC107.4 (V-)
B0: IC105.4 (A0)
B1: IC105.5 (A1)
C0: IC104.4 (A0)
C1: IC104.5 (A1)
Current_+: IC105.10 (+)
Current_-: IC105.1 (-)
Current_ADC: C139.2, R146.1, U108.1
D0: IC106.5 (G0)
D1: IC106.6 (G1)
D2: IC106.7 (G2)
E0: IC107.5 (G0)
E1: IC107.6 (G1)
E2: IC107.7 (G2)
GND: C131.1, C132.1, C133.1, C134.1, C135.1, C136.1, C137.1, C138.1, C141.1, C142.1, C143.1, C144.1, C145.1, C146.1, IC104.2 (DGND), IC104.9 (Ref), IC105.2 (DGND), IC105.9 (Ref), IC106.2 (AGND), IC107.2 (AGND), U108.4 (V-)
unnamed: C139.1, R143.1, R146.2, U108.2 (-)
unnamed: C140.1, R145.1, R147.2, U108.6 (-)
unnamed: IC104.7, IC107.3 (IN), TP106.1
unnamed: IC105.7, IC106.3 (IN), TP107.1
unnamed: IC106.1 (Out), R143.2
unnamed: IC107.1 (Out), R145.2
unnamed: R142.1, U108.3 (+)
unnamed: R144.1, U108.5 (+)
Voltage_+: IC104.10 (+)
Voltage_-: IC104.1 (-)
Voltage_ADC: C140.2, R147.1, U108.7

Notes on the sheet:
1,2,4,8,16,32 PGA
50MHz op amp to reload SAR ADC capacitance Adding 1V DC offset
place close to U108
place close to IN AMP
place close to PGA
1,10,100 High bandwidth instrumental PGA
